jason-merlo/muse/README.md

# Muse
A Spark Core based music visualizer using the MSEGEQ7 spectrum analyzer IC

Bill of materials for v1.2 located at: https://goo.gl/ZPPZxI

A full writeup for this project will hopefully come sometime in the near future.
