jason-merlo/muse/Hardware V1.0/muse.pdf

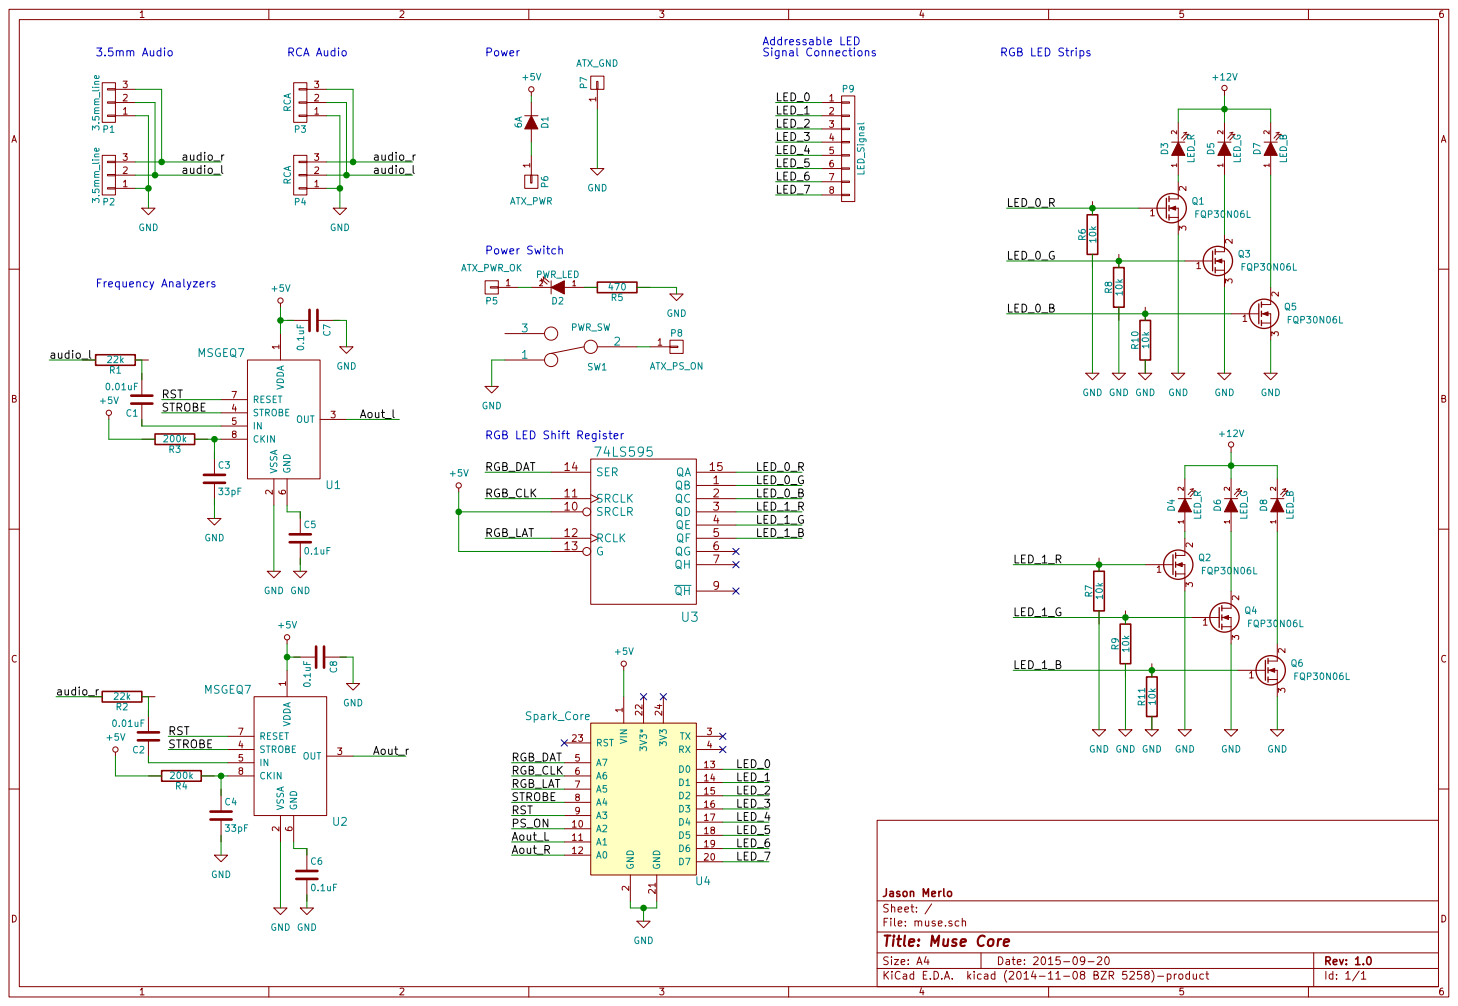
[picture p1: page 1]

2 TX 3 RX 4 A7 5 A6 6 A5 7 A4 8 A3 9 A2 10 D7 20 A1 11 GND 21 A0 12 3V3* 22 D0 13 RST 23 D1 14 3V3 24 D2 15 D3 16 D4 17 D5 18 D6 19 U4 Spark_Core VDDA

1 GND
File: muse.sch Sheet: / Jason Merlo VIN

Id: 1/1 Title: Muse Core
