jason-merlo/muse/Hardware V1.0/muse.kicad_pcb

## KiCad design Hardware V1.0/muse.kicad_pcb (2015-12-21, an earlier design)

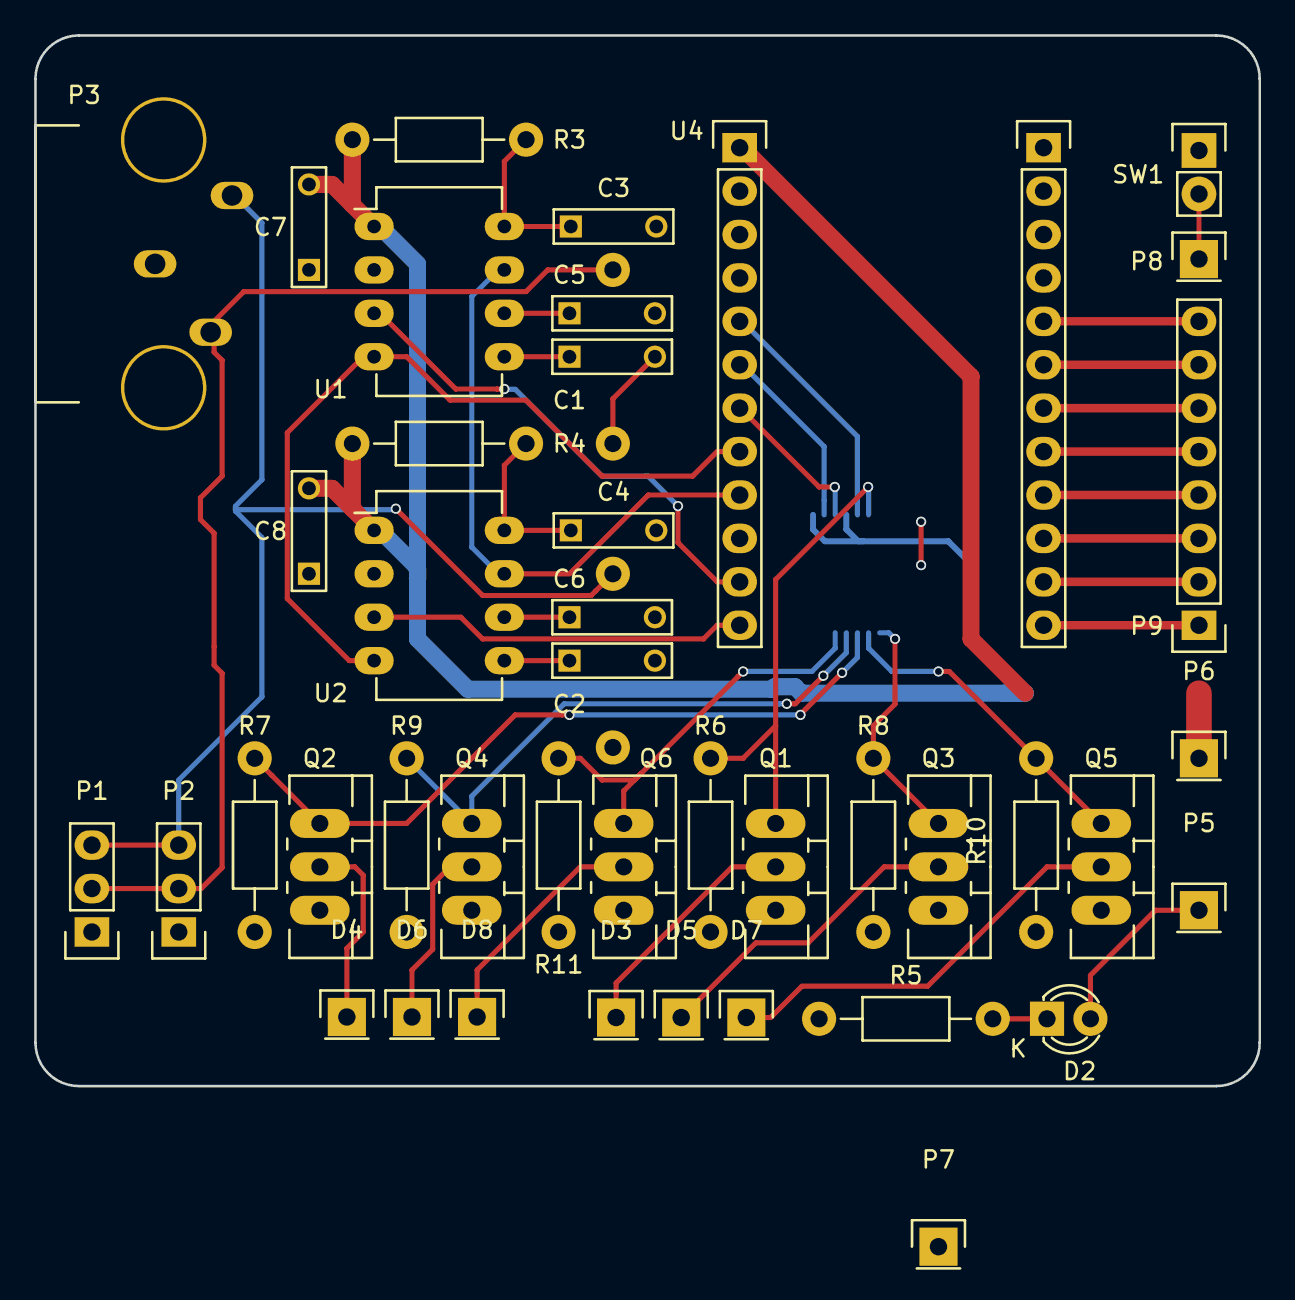
[picture p2: board Hardware V1.0/muse.kicad_pcb from above]

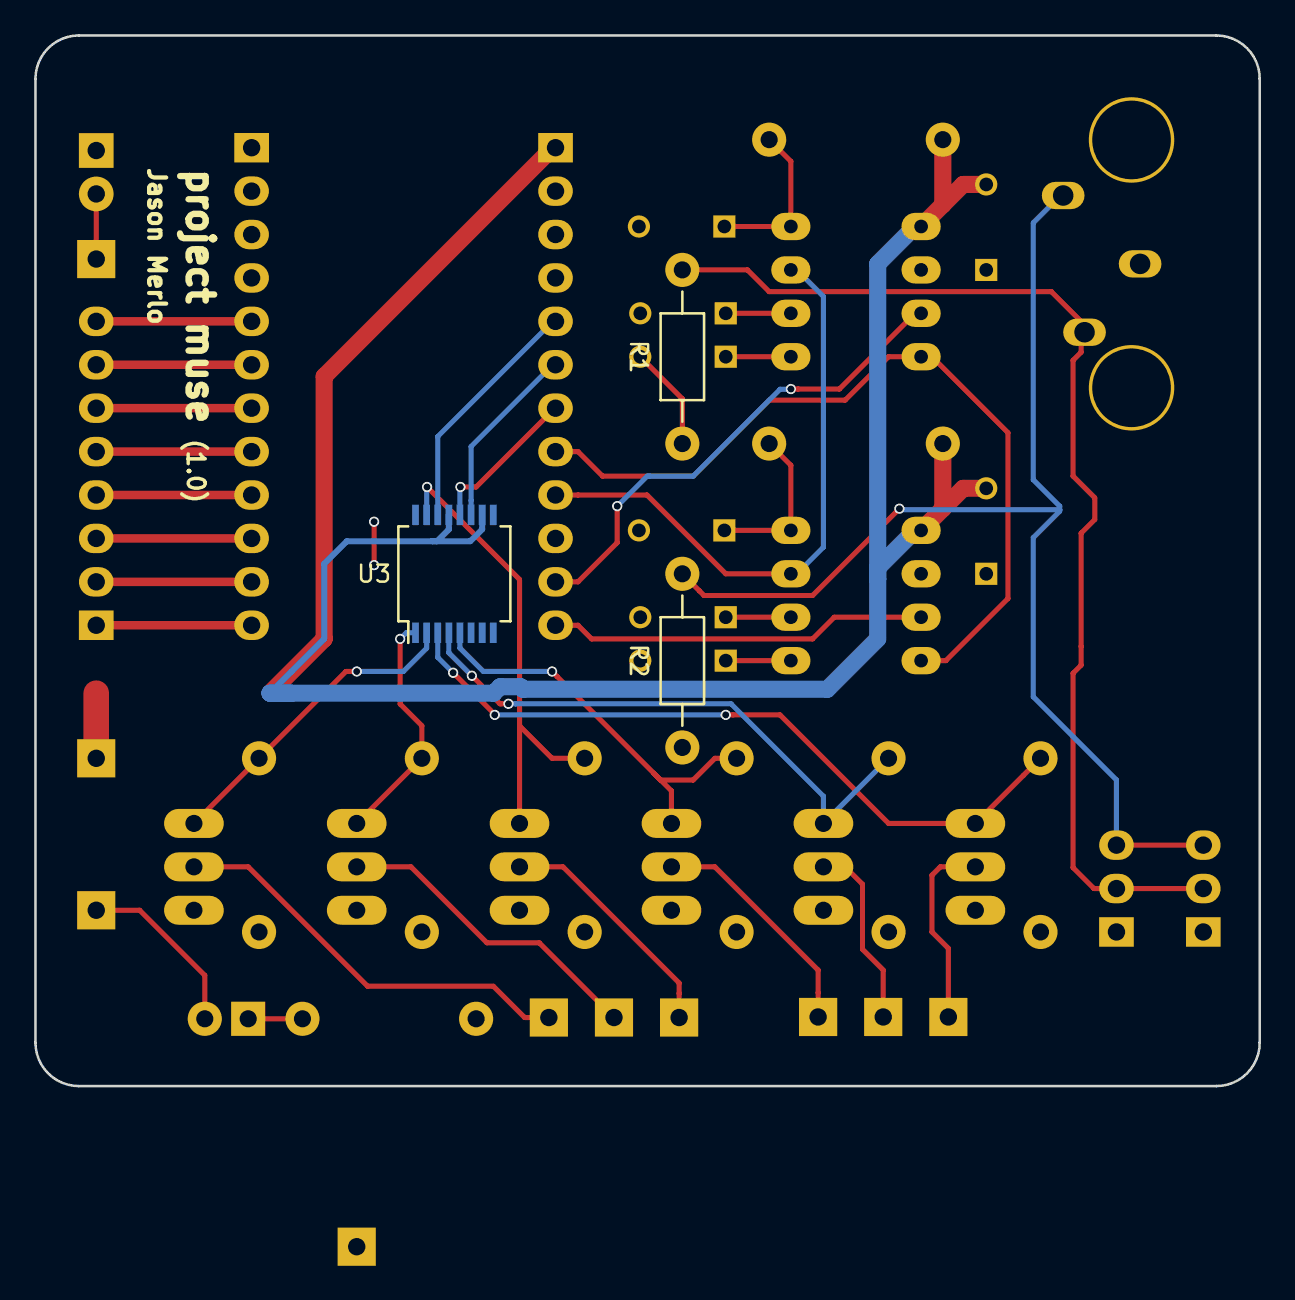
[picture p3: board Hardware V1.0/muse.kicad_pcb from below]

Board: 2 copper layers, 71.6 x 61.5 mm, 45 parts (3 on the bottom side), 42 nets.

Parts:
C1, C2: 0.01uF; C_Rect_L7_W2_P5
C3, C4: 33pF; C_Rect_L7_W2_P5
C5, C6, C7, C8: 0.1uF; C_Rect_L7_W2_P5
D2: PWR_LED; LED-3MM
D3, D4: LED_R; Pin_Header_Straight_1x01
D5, D6: LED_G; Pin_Header_Straight_1x01
D7, D8: LED_B; Pin_Header_Straight_1x01
P1, P2: 3.5mm_line; Pin_Header_Straight_1x03
P3: RCA; Audio_RCA_Vertical
P5: ATX_PWR_OK; Pin_Header_Straight_1x01
P6: ATX_PWR; Pin_Header_Straight_1x01
P7: ATX_GND; Pin_Header_Straight_1x01
P8: ATX_PS_ON; Pin_Header_Straight_1x01
P9: LED_Signal; Pin_Header_Straight_1x08
Q1, Q2, Q3, Q4, Q5, Q6: FQP30N06L; TO-220_Neutral123_Vertical_LargePads
R1, R2: 22k; Resistor_Horizontal_RM10mm
R3, R4: 200k; Resistor_Horizontal_RM10mm
R5: 470; Resistor_Horizontal_RM10mm
R6, R7, R8, R9, R10, R11: 10k; Resistor_Horizontal_RM10mm
SW1: PWR_SW; Pin_Header_Straight_1x02
U1, U2: MSGEQ7; DIP-8_W7.62mm_LongPads
U3: 74LS595; SSOP-16_5.3x6.2mm_Pitch0.65mm
U4: Spark_Core

Connections:
+5V: C7.2, C8.2, R3.2, R4.2, U1.1, U2.1, U3.10, U3.13, U4.1
/Aout_L: U1.3, U4.11
/Aout_R: U2.3, U4.12
/LED_0: P9.1, U4.13
/LED_0_B: Q5.1, R10.2, U3.2
/LED_0_G: Q3.1, R8.2, U3.1
/LED_0_R: Q1.1, R6.2, U3.15
/LED_1: P9.2, U4.14
/LED_1_B: Q6.1, R11.2, U3.5
/LED_1_G: Q4.1, R9.2, U3.4
/LED_1_R: Q2.1, R7.2, U3.3
/LED_2: P9.3, U4.15
/LED_3: P9.4, U4.16
/LED_4: P9.5, U4.17
/LED_5: P9.6, U4.18
/LED_6: P9.7, U4.19
/LED_7: P9.8, U4.20
/RGB_CLK: U3.11, U4.6
/RGB_DAT: U3.14, U4.5
/RGB_LAT: U3.12, U4.7
/RST: U1.7, U2.7, U4.9
/STROBE: U1.4, U2.4, U4.8
/audio_l: P1.2, P2.2, R1.2
/audio_r: P1.3, P2.3, R2.2
GND: C3.2, C4.2, C5.2, C6.2, C7.1, C8.1, P1.1, P2.1, P7.1, Q1.3, Q2.3, Q3.3, Q4.3, Q5.3, Q6.3, R5.1, R6.1, R7.1, R8.1, R9.1, R10.1, R11.1, SW1.1, U1.2, U2.2, U3.8, U4.2, U4.21
unnamed: C1.1, U1.5
unnamed: C1.2, R1.1
unnamed: C2.1, U2.5
unnamed: C2.2, R2.1
unnamed: C3.1, R3.1, U1.8
unnamed: C4.1, R4.1, U2.8
unnamed: C5.1, U1.6
unnamed: C6.1, U2.6
unnamed: D2.1, R5.2
unnamed: D2.2, P5.1
unnamed: D3.1, Q1.2
unnamed: D4.1, Q2.2
unnamed: D5.1, Q3.2
unnamed: D6.1, Q4.2
unnamed: D7.1, Q5.2
unnamed: D8.1, Q6.2
unnamed: P8.1, SW1.2
