jason-merlo/muse/Hardware V1.3/muse.kicad_pcb

## KiCad design Hardware V1.3/muse.kicad_pcb (2021-03-27, an earlier design)

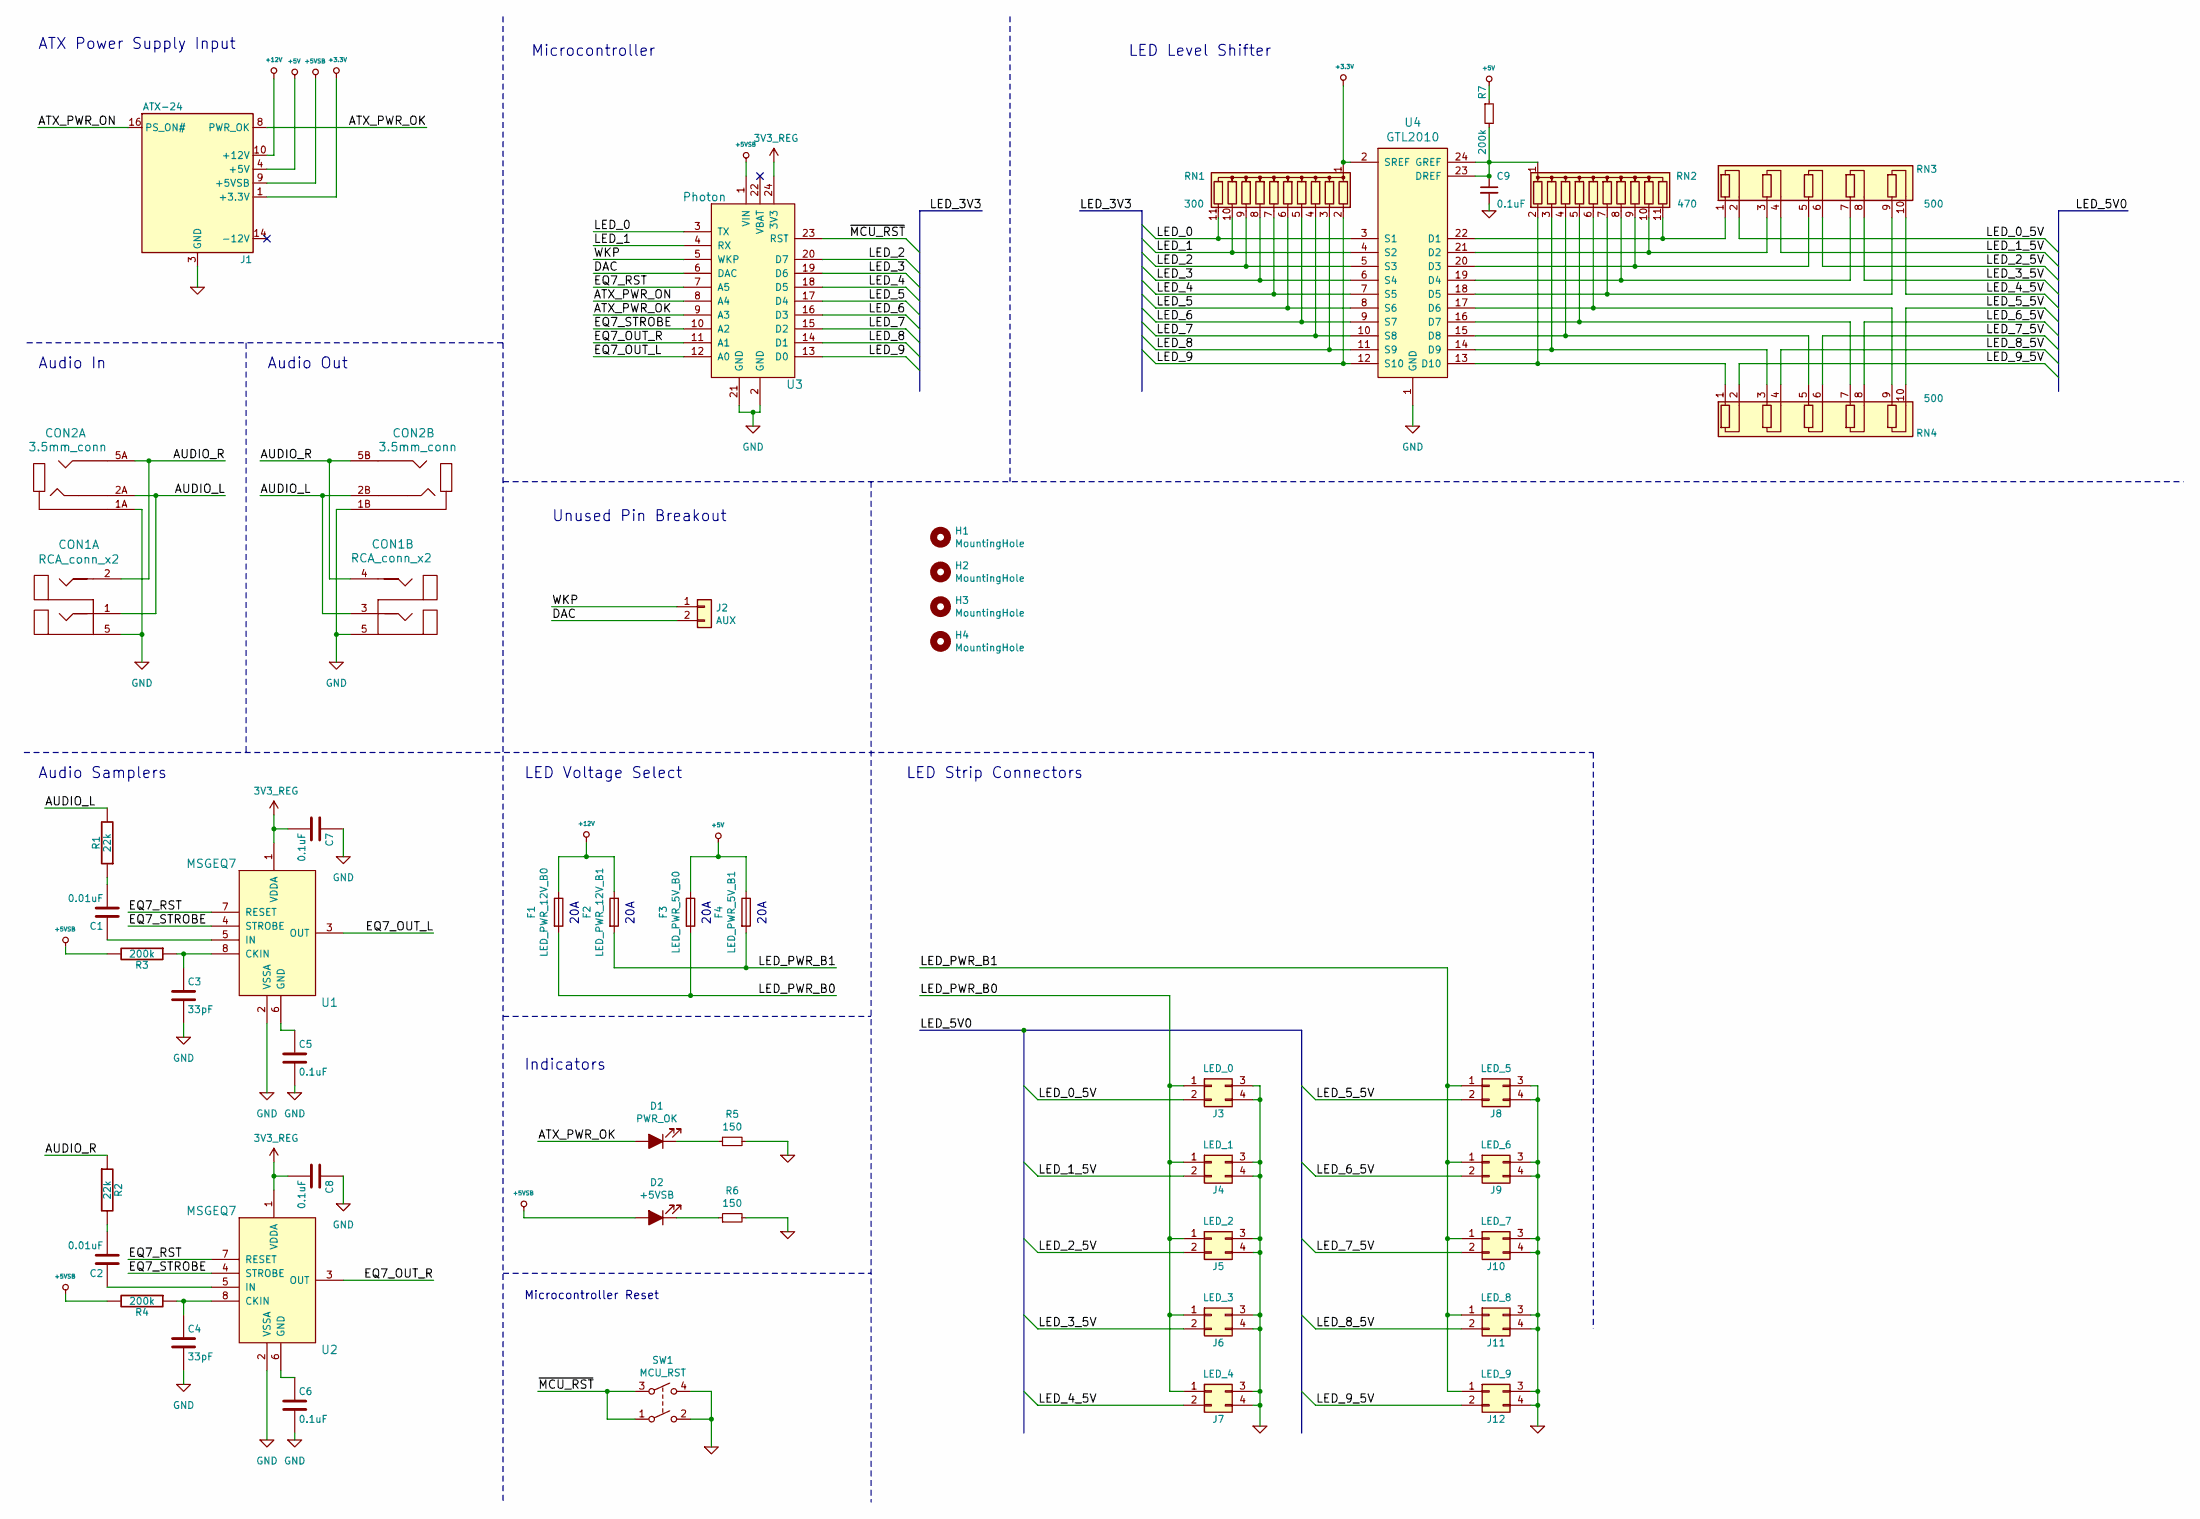
[picture p4: schematic muse.sch]

Parts:
C1, C2: 0.01uF; C_Rect_L4.6mm_W3.0mm_P2.50mm_MKS02_FKP02
C3, C4: 33pF; C_Rect_L4.6mm_W3.0mm_P2.50mm_MKS02_FKP02
C5, C6, C7, C8, C9: 0.1uF; C_Rect_L4.6mm_W3.0mm_P2.50mm_MKS02_FKP02
CON1: RCA_conn_x2; PJRAS2X2S01X
CON2: 3.5mm_conn; STX423535N
D1: PWR_OK; LED_D3.0mm
D2: +5VSB; LED_D3.0mm
F1: LED_PWR_12V_B0; Fuseholder_Blade_Mini_Keystone_3568
F2: LED_PWR_12V_B1; Fuseholder_Blade_Mini_Keystone_3568
F3: LED_PWR_5V_B0; Fuseholder_Blade_Mini_Keystone_3568
F4: LED_PWR_5V_B1; Fuseholder_Blade_Mini_Keystone_3568
H1, H2, H3, H4: MountingHole; MountingHole_3.2mm_M3
J1: ATX-24; Molex_Mini-Fit_Jr_5569-24A1_2x12_P4.20mm_Horizontal
J2: AUX; PinHeader_1x02_P2.54mm_Vertical
J3: LED_0; Molex_Mini-Fit_Jr_5569-04A1_2x02_P4.20mm_Horizontal
J4: LED_1; Molex_Mini-Fit_Jr_5569-04A1_2x02_P4.20mm_Horizontal
J5: LED_2; Molex_Mini-Fit_Jr_5569-04A1_2x02_P4.20mm_Horizontal
J6: LED_3; Molex_Mini-Fit_Jr_5569-04A1_2x02_P4.20mm_Horizontal
J7: LED_4; Molex_Mini-Fit_Jr_5569-04A1_2x02_P4.20mm_Horizontal
J8: LED_5; Molex_Mini-Fit_Jr_5569-04A1_2x02_P4.20mm_Horizontal
J9: LED_6; Molex_Mini-Fit_Jr_5569-04A1_2x02_P4.20mm_Horizontal
J10: LED_7; Molex_Mini-Fit_Jr_5569-04A1_2x02_P4.20mm_Horizontal
J11: LED_8; Molex_Mini-Fit_Jr_5569-04A1_2x02_P4.20mm_Horizontal
J12: LED_9; Molex_Mini-Fit_Jr_5569-04A1_2x02_P4.20mm_Horizontal
R1, R2: 22k; R_Axial_DIN0207_L6.3mm_D2.5mm_P10.16mm_Horizontal
R3, R4, R7: 200k; R_Axial_DIN0207_L6.3mm_D2.5mm_P10.16mm_Horizontal
R5, R6: 150; R_Axial_DIN0207_L6.3mm_D2.5mm_P10.16mm_Horizontal
RN1: 300; R_Array_SIP11
RN2: 470; R_Array_SIP11
RN3, RN4: 500; R_Array_SIP10
SW1: MCU_RST; SW_TH_Tactile_Omron_B3F-10xx
U1, U2: MSGEQ7; DIP-8_W7.62mm_LongPads
U3: Photon; photon_tht
U4: GTL2010; TSSOP-24_4.4x7.8mm_P0.65mm

Connections:
+3.3V: J1.1 (+3.3V), J1.2 (+3.3V), J1.12 (+3.3V), J1.13 (+3.3V), RN1.1 (common), U4.2 (SREF)
+3.3V_REG: C7.2, C8.2, U1.1 (VDDA), U2.1 (VDDA), U3.24 (3V3)
+5V: F3.1, F4.1, J1.4 (+5V), J1.6 (+5V), J1.21 (+5V), J1.22 (+5V), J1.23 (+5V), R7.1
+5VSB: D2.2 (A), J1.9 (+5VSB), R3.2, R4.2, U3.1 (VIN)
+12V: F1.1, F2.1, J1.10 (+12V), J1.11 (+12V)
/ATX_PWR_OK: D1.2 (A), J1.8 (PWR_OK), U3.9 (A3)
/ATX_PWR_ON: J1.16 (PS_ON#), U3.8 (A4)
/AUDIO_L: CON1.1, CON1.3, CON2.2A, CON2.2B, R1.2
/AUDIO_R: CON1.2, CON1.4, CON2.5A, CON2.5B, R2.1
/DAC: J2.2, U3.6 (DAC)
/EQ7_OUT_L: U1.3 (OUT), U3.12 (A0)
/EQ7_OUT_R: U2.3 (OUT), U3.11 (A1)
/EQ7_RST: U1.7 (RESET), U2.7 (RESET), U3.7 (A5)
/EQ7_STROBE: U1.4 (STROBE), U2.4 (STROBE), U3.10 (A2)
/LED_0: RN1.11 (R10), U3.3 (TX), U4.3 (S1)
/LED_0_5V: J3.2, RN3.2 (R1.2)
/LED_1: RN1.10 (R9), U3.4 (RX), U4.4 (S2)
/LED_1_5V: J4.2, RN3.4 (R2.2)
/LED_2: RN1.9 (R8), U3.20 (D7), U4.5 (S3)
/LED_2_5V: J5.2, RN3.6 (R3.2)
/LED_3: RN1.8 (R7), U3.19 (D6), U4.6 (S4)
/LED_3_5V: J6.2, RN3.8 (R4.2)
/LED_4: RN1.7 (R6), U3.18 (D5), U4.7 (S5)
/LED_4_5V: J7.2, RN3.10 (R5.2)
/LED_5: RN1.6 (R5), U3.17 (D4), U4.8 (S6)
/LED_5_5V: J8.2, RN4.10 (R5.2)
/LED_6: RN1.5 (R4), U3.16 (D3), U4.9 (S7)
/LED_6_5V: J9.2, RN4.8 (R4.2)
/LED_7: RN1.4 (R3), U3.15 (D2), U4.10 (S8)
/LED_7_5V: J10.2, RN4.6 (R3.2)
/LED_8: RN1.3 (R2), U3.14 (D1), U4.11 (S9)
/LED_8_5V: J11.2, RN4.4 (R2.2)
/LED_9: RN1.2 (R1), U3.13 (D0), U4.12 (S10)
/LED_9_5V: J12.2, RN4.2 (R1.2)
/LED_PWR_B0: F1.2, F3.2, J3.1, J4.1, J5.1, J6.1, J7.1
/LED_PWR_B1: F2.2, F4.2, J8.1, J9.1, J10.1, J11.1, J12.1
/WKP: J2.1, U3.5 (WKP)
/~MCU_RST: SW1.1, SW1.3, U3.23 (RST)
unnamed: C1.1, U1.5 (IN)
unnamed: C1.2, R1.1
unnamed: C2.1, U2.5 (IN)
unnamed: C2.2, R2.2
unnamed: C3.1, R3.1, U1.8 (CKIN)
unnamed: C4.1, R4.1, U2.8 (CKIN)
unnamed: C5.1, U1.6 (GND)
unnamed: C6.1, U2.6 (GND)
unnamed: C9.1, R7.2, RN2.1 (common), U4.23 (DREF), U4.24 (GREF)
unnamed: D1.1 (K), R5.1
unnamed: D2.1 (K), R6.1
unnamed: RN2.2 (R1), RN4.1 (R1.1), U4.13 (D10)
unnamed: RN2.3 (R2), RN4.3 (R2.1), U4.14 (D9)
unnamed: RN2.4 (R3), RN4.5 (R3.1), U4.15 (D8)
unnamed: RN2.5 (R4), RN4.7 (R4.1), U4.16 (D7)
unnamed: RN2.6 (R5), RN4.9 (R5.1), U4.17 (D6)
unnamed: RN2.7 (R6), RN3.9 (R5.1), U4.18 (D5)
unnamed: RN2.8 (R7), RN3.7 (R4.1), U4.19 (D4)
unnamed: RN2.9 (R8), RN3.5 (R3.1), U4.20 (D3)
unnamed: RN2.10 (R9), RN3.3 (R2.1), U4.21 (D2)
unnamed: RN2.11 (R10), RN3.1 (R1.1), U4.22 (D1)

Notes on the sheet:
Audio Samplers
LED Level Shifter
ATX Power Supply Input
Audio Out
Audio In
Microcontroller
LED Strip Connectors
Unused Pin Breakout
20A
LED Voltage Select
Indicators
Microcontroller Reset

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
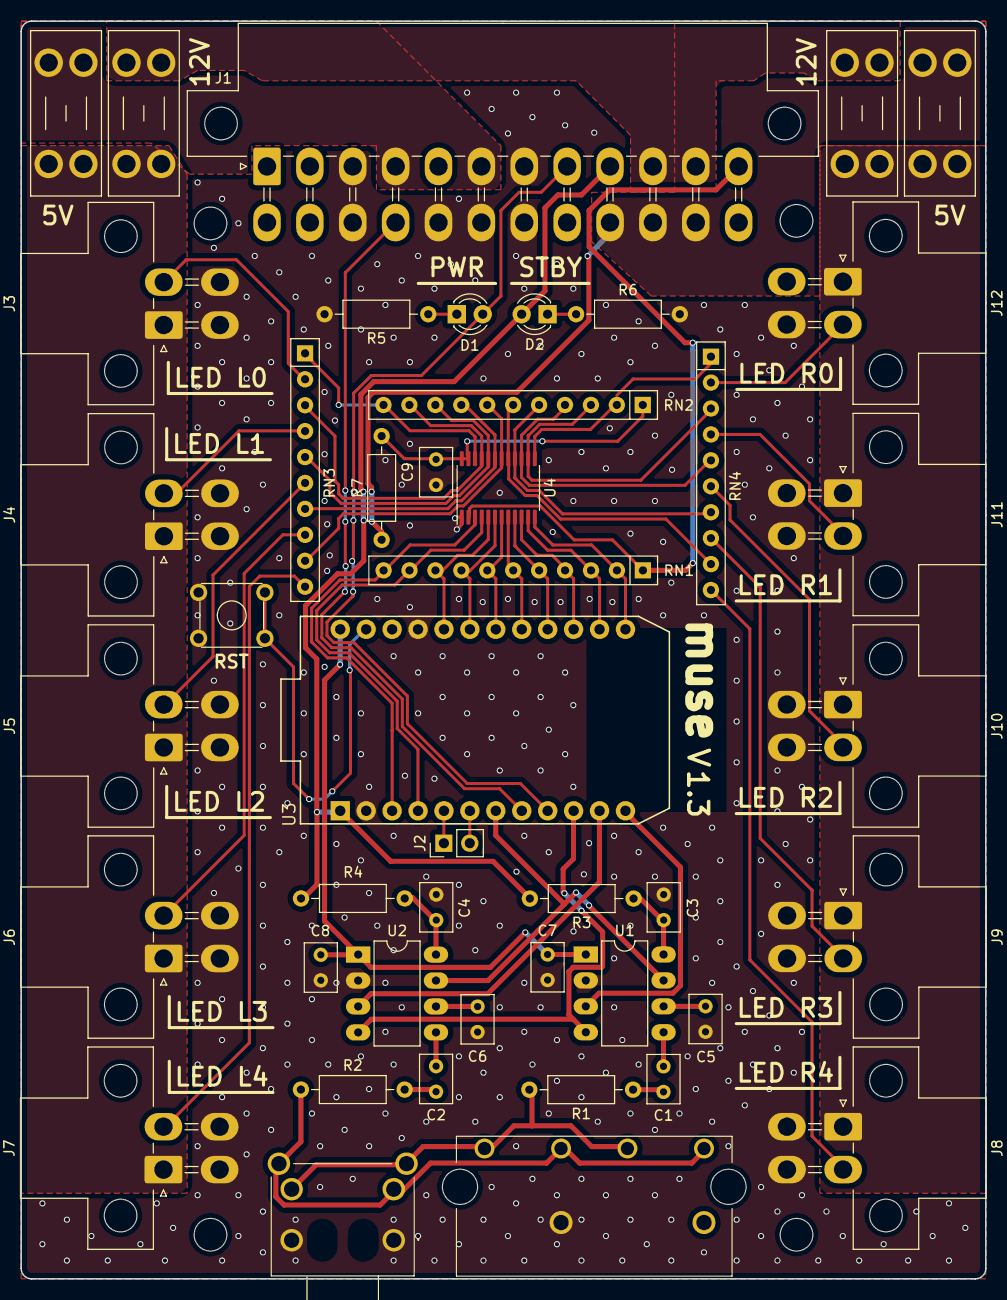
[picture p5: board Hardware V1.3/muse.kicad_pcb from above]

Board: 2 copper layers, 94.5 x 123.2 mm, 49 parts (0 on the bottom side), 60 nets.
