jason-merlo/muse/muse/bar_matrix.cpp

/* ================================================================== *
 *  Written by Jason Merlo
 *
 *  updates:
 *  11/17/2015
 *
 *  File: bar_matrix.cpp
 *
 *  Description: Class to control LED bar matrix and run visualizers
 * ================================================================== */

#include "bar_matrix.h"
#include "math.h"

// Display variables
short disp_width;
short disp_height;
unsigned long** display;
Adafruit_NeoPixel** bars;

Beat_Detection * bd;

int color_table_idx = 0;

/* ================================================================== *
 * Bar_matrix
 *
 * num_bars - number of LED bars
 * bar_len - number of leds in each bar (strip length)
 * orientation - horizontal or vertical bars (horizontal/ladder = 0; vertical/fence = 1)
 * ================================================================== */
Bar_Matrix::Bar_Matrix(short num_bars, short bar_len, const char led_type, const char* pins, Beat_Detection* beat_detection) {
    disp_width = num_bars; //(orientation) ? num_bars : bar_len;
    disp_height = bar_len; //(orientation) ? bar_len : num_bars;

    display = new unsigned long*[disp_width];
    for (int i = 0; i < disp_width; i++)
    display[i] = new unsigned long[disp_height];

    bars = new Adafruit_NeoPixel*[num_bars];
    for(short i = 0; i < num_bars; i++) {
        bars[i] = new Adafruit_NeoPixel(bar_len, pins[i], led_type);

        // Set up variables to track bouncing lines
        bouncing_line_lengths[i] = random(10, STRIP_LENGTH / 2);
        bouncing_line_positions[i] = random(0, STRIP_LENGTH);
        //bouncing_line_positions[i] = (i%2 == 0) ? 0 : STRIP_LENGTH;
        if (random(0, 10) > 5) bouncing_line_directions[i] = 1;
        else                bouncing_line_directions[i] = -1;

        bouncing_line_speeds[i] = (float)random(5, 10) / 15.0;

        bouncing_line_colors[i][0] = bd->r();
        bouncing_line_colors[i][1] = bd->g();
        bouncing_line_colors[i][2] = bd->b();
    }

    color_table_idx = 0;
    snakes[0] = Snake(1, 30, -30, COLOR_TABLE[color_table_idx][0], COLOR_TABLE[color_table_idx][1], COLOR_TABLE[color_table_idx][2]);
    color_table_idx++;
    snakes[1] = Snake(-1, 25, NUM_BARS/2*STRIP_LENGTH, COLOR_TABLE[color_table_idx][0], COLOR_TABLE[color_table_idx][1], COLOR_TABLE[color_table_idx][2]);
    color_table_idx++;
    snakes[2] = Snake(1, 20, 185, COLOR_TABLE[color_table_idx][0], COLOR_TABLE[color_table_idx][1], COLOR_TABLE[color_table_idx][2]);
    color_table_idx++;
    snakes[3] = Snake(-1, 15, NUM_BARS*STRIP_LENGTH, COLOR_TABLE[color_table_idx][0], COLOR_TABLE[color_table_idx][1], COLOR_TABLE[color_table_idx][2]);
    color_table_idx++;

    snakes[0].posTicks = 0;
    snakes[0].ticksNeeded = 1;
    snakes[1].posTicks = 0;
    snakes[1].ticksNeeded = 1;
    snakes[2].posTicks = 0;
    snakes[2].ticksNeeded = 1;
    snakes[3].posTicks = 0;
    snakes[3].ticksNeeded = 1;

    pongPaddles[0] = PongPaddle(15, 0, STRIP_LENGTH/2, 0, 0.9, 15, 100, 100, 100);
    pongPaddles[1] = PongPaddle(15, NUM_BARS-1, STRIP_LENGTH/2, 0, 0.9, 15, 100, 100, 100);
    pongBall = PongBall(3, 0.0625, 0.80, 15, 100, 100, 100);
    last_beat_count = 0;

    bass_slide_millis = millis();
    bass_slide_ema = 0.0;

    init_matrix();
    clear_matrix();

    bd = beat_detection;
}

/* ======================== PRIVATE FUNCTIONS ======================= */

/* ================================================================== *
 * Function: decay
 * Description: slowly fades out matrix values
 * Parameters: [float] factor - decay factor to be multiplied by
 * ================================================================== */
void Bar_Matrix::decay(double factor) {
    for (char i = 0; i < disp_width; i++) {
        for (char j = 0; j < disp_height; j++) {
            unsigned int color = bars[i]->getPixelColor(j);
            bars[i]->setPixelColor(j, (char)(color >> 16) * factor,
            (char)(color >> 8) * factor,
            (char)(color) * factor);
        }
    }
}

/* ================================================================== *
 * Function: decay_to_rgb
 * Description: slowly fades out matrix values to the specified rgb value
 * Parameters: [float] factor - decay factor to be multiplied by
 *             [int] r - the red value to fade to
 *             [int] g - the green value to fade to
 *             [int] b - the blue value to fade to
 * ================================================================== */
void Bar_Matrix::decay_to_rgb(double factor, int r, int g, int b) {
    for (char i = 0; i < disp_width; i++) {
        for (char j = 0; j < disp_height; j++) {
            unsigned int color = bars[i]->getPixelColor(j);

            // Decay and do bounds checking on rgb values
            int rx = (int) ((char)(color >> 16) * factor);
            int gx = (int) ((char)(color >>  8) * factor);
            int bx = (int) ((char)(color      ) * factor);
            if (rx < r) { rx = r; }
            if (gx < g) { gx = g; }
            if (bx < b) { bx = b; }

            bars[i]->setPixelColor(j, rx, gx, bx);
        }
    }
}

void Bar_Matrix::fill_bar(int bar, int r, int g, int b) {
    for (int j =0; j < disp_height; j++) {
        bars[bar]->setPixelColor(j, (uint8_t)r, (uint8_t)g, (uint8_t)b);
    }
}

/* ================================================================== *
 * Function: fill_matrix
 * Description: Sets all pixel values in matrix to given color value
 * Parameters: [Color]* color - color to set matrix to
 * ================================================================== */
void Bar_Matrix::fill_matrix(Color_Value c) {
    for (int i = 0; i < disp_width; i++) {
        for (int j =0; j< disp_height; j++) {
            bars[i]->setPixelColor(j, c.c);
        }
    }
}

/* ================================================================== *
 * Function: ambient_lighting
 * Description: Sets all pixel values in matrix to given color value
 * Parameters: [Color]* color - color to set matrix to
 * ================================================================== */
void Bar_Matrix::ambient_lighting(Color_Value c) {
    fill_matrix(c);
}


/* ================================================================== *
 * Function: init_matrix
 * Description: Initializes the matrix to off
 * ================================================================== */
void Bar_Matrix::init_matrix() {
    for (int i = 0; i < disp_width; i++) {
        // switch height and width based on orientation
        bars[i]->begin();
        bars[i]->show();
    }
}

void Bar_Matrix::mix_pixel(unsigned char bar, unsigned short pixel, float factor, unsigned char r, unsigned char g, unsigned char b) {
    unsigned int color = bars[bar]->getPixelColor(pixel);
    bars[bar]->setPixelColor(pixel, (char)(color >> 16) * (1-factor) + r * factor,
    (char)(color >> 8) * (1-factor) + g * factor,
    (char)(color) * (1-factor) + b * factor);
}

/* =================== PUBLIC MANAGEMENT FUNCTIONS ================== */

/* ================================================================== *
 * Function: clear_matrix
 * Description: Sets all pixel values to (0, 0, 0)
 * ================================================================== */
void Bar_Matrix::clear_matrix() {
    for (int i = 0; i < disp_width; i++) {
        for (int j =0; j< disp_height; j++) {
            bars[i]->setPixelColor(j, 0);
        }
    }
}

/* ================================================================== *
 * Function: show_all
 * Description: drives pixels in physical matrix to current values
 * ================================================================== */
void Bar_Matrix::show_all() {
    for (char i = 0; i < disp_width; i++) {
        bars[i]->show();
    }
}

/* ================================================================== *
 * Function: tick
 * Description: Draws the given visualizer to the bars
 * Parameters: [audio_bins *] bins - The audio sample bins
 *             [int] visualizer_type - The visualizer type to drive
 * ================================================================== */
void Bar_Matrix::tick(audio_bins * bins, int visualizer_type) {
    switch (visualizer_type) {
        // Visualizers
        case VISUALIZER_BARS:
          visualizer_bars(bins, 0.15, 0.85, false);
          break;
        case VISUALIZER_BARS_MIDDLE:
          visualizer_bars_middle(bins, 0.15, 0.85);
          break;
        case VISUALIZER_BASS_MIDDLE:
          visualizer_bass_middle(bins, 0.15, 0.80);
          break;
        case VISUALIZER_BASS_SLIDE:
          visualizer_bass_slide(bins, 0.15, 0.75);
          break;
        case VISUALIZER_CLASSIC:
            visualizer_classic(bins, 0.15, 0.9);
            break;
        case VISUALIZER_PLASMA:
          visualizer_plasma(bins, 0.5, 0.965);
          break;
        case VISUALIZER_PONG:
          visualizer_pong(0.965);
          break;
        case VISUALIZER_PULSE:
          visualizer_pulse(bins, 0.15, 0.8, 1.0f, 20.0f);
          break;
        case VISUALIZER_RAINBOW:
          visualizer_rainbow(bins, 0.15, 0.8);
          break;
        case VISUALIZER_WHEEL:
          visualizer_wheel(0.25, 10);
          break;

        // Tests and misc
        case BOUNCING_LINES:
            bouncing_lines();
            break;
        case SNAKE_LINES:
            snake_lines(0.75);
            break;
        case BAR_TEST:
            bar_test();
            break;
        case PIXEL_TEST:
            pixel_test();
            break;
        case AMBIENT_LIGHTING:
            ambient_lighting(Color_Value(200, 150, 100));
            break;
    }

    bd->frame_ticked();
    show_all();
}

/* ===================== MISC DRAWING FUNCTIONS ===================== */

/* ================================================================== *
 * Function: bar_test
 * Description: Turns on bars in order to test wiring
 * Parameters: None
 * ================================================================== */
void Bar_Matrix::bar_test() {
    for (int i = 0; i < STRIP_LENGTH; i++)
    bars[int(millis()/1000) % NUM_BARS]->setPixelColor(i, 64, 64, 64);
}

/* ================================================================== *
 * Function: bouncing_lines
 * Description: Bounces a solid line of LEDs up and down in each matrix bar
 * Parameters: none
 * ================================================================== */
void Bar_Matrix::bouncing_lines() {
    for (int i = 0; i < disp_width; i++) {
        int bottom = bouncing_line_positions[i];

        // Clear the pixel the line just left, light the one it entered
        if (bouncing_line_directions[i] == 1) {
            if (bottom > 0) mix_pixel(i, bottom-1, 1, 0, 0, 0);
            mix_pixel(i, 1+bottom+bouncing_line_lengths[i], 1, bouncing_line_colors[i][0], bouncing_line_colors[i][1], bouncing_line_colors[i][2]);//bd->r(), bd->g(), bd->b());
        } else {
            if (bottom > 0) mix_pixel(i, bottom-1, 1, bouncing_line_colors[i][0], bouncing_line_colors[i][1], bouncing_line_colors[i][2]);//bd->r(), bd->g(), bd->b());
            mix_pixel(i, 1+bottom+bouncing_line_lengths[i], 1, 0, 0, 0);
        }

        // Move the line
        bouncing_line_positions[i] += bouncing_line_directions[i] * bouncing_line_speeds[i];

        // Ensure we are moving in the proper direction
        if (bouncing_line_positions[i] < -.5*bouncing_line_lengths[i] && bouncing_line_directions[i] < 0) {
            bouncing_line_directions[i] = 1;
            if (random(0, 10) > 5) {
                int newlength = random(10, STRIP_LENGTH / 2);
                if (newlength > bouncing_line_lengths[i]) {
                    bouncing_line_positions[i] = (-1*newlength/2) - (newlength/2 - bouncing_line_lengths[i]/2);
                } else {
                    bouncing_line_positions[i] = -1 * newlength / 2;
                }

                bouncing_line_lengths[i] = newlength;
            }

            if (random(0, 10) > 7) {
                bouncing_line_speeds[i] = (float)random(5, 10) / 15.0;
            }

            bouncing_line_colors[i][0] = bd->r();
            bouncing_line_colors[i][1] = bd->g();
            bouncing_line_colors[i][2] = bd->b();
        } else if (bouncing_line_positions[i] > STRIP_LENGTH-.5*bouncing_line_lengths[i] && bouncing_line_directions[i] > 0) {
            bouncing_line_directions[i] = -1;

            bouncing_line_colors[i][0] = bd->r();
            bouncing_line_colors[i][1] = bd->g();
            bouncing_line_colors[i][2] = bd->b();
        }
    }
}

/* ================================================================== *
 * Function: bar_test
 * Description: Turns on lights from top to check length of srip
 * Parameters: None
 * ================================================================== */
void Bar_Matrix::pixel_test() {
    clear_matrix();
    for (int i = 0; i < NUM_BARS; i++)
    bars[i]->setPixelColor(STRIP_LENGTH-int(millis()/1000)%10, 64, 64, 64);
}

/* ================== VISUALIZER DRAWING FUNCTIONS ================== */

/* ================================================================== *
 * Function: visualizer_bars
 * Description: Sets all pixel values to given color value
 * Parameters: [audio_bins]* bins - frequency bins read from chip
 * ================================================================== */
 void Bar_Matrix::visualizer_bars(audio_bins* bins, float in_factor, float out_factor, bool strobe) {
   decay(out_factor);
   float bass_level = 0;
   int red, green, blue;

   if (strobe)
     bass_level = (log(((bins->left[LEFT_63]+bins->right[LEFT_63])/2.0f)/BINS_MAX)+0.7f) * 5 * 255.0f;

   for (char i = 0; i < disp_width; i++) {
     for (char j = 0; j < disp_height; j++) {
       // get bin
       //int level = (i < disp_width/2) ? bar_levels[i] : bar_levels[7-i];

       if (strobe)
         mix_pixel(i, j, 0.5f, bass_level, bass_level, bass_level);

       // Set bar levels
       int level = 0;
       if (disp_width == 8) {
        switch(i) {
            case 0:
            level = bins->left[LEFT_160];
            break;
            case 1:
            level = bins->left[LEFT_1000];
            break;
            case 2:
            level = bins->left[LEFT_6250];
            break;
            case 3:
            level = bins->left[LEFT_16000];
            break;
            case 4:
            level = bins->right[RIGHT_16000];
            break;
            case 5:
            level = bins->right[RIGHT_6250];
            break;
            case 6:
            level = bins->right[RIGHT_1000];
            break;
            case 7:
            level = bins->right[RIGHT_160];
            break;
        }
        } else if (disp_width == 10) {
            switch(i) {
            case 0:
            level = bins->left[LEFT_63];
            break;
            case 1:
            level = bins->left[LEFT_160];
            break;
            case 2:
            level = bins->left[LEFT_400];
            break;
            case 3:
            level = bins->left[LEFT_1000];
            break;
            case 4:
            level = bins->left[LEFT_6250];
            break;
            case 5:
            level = bins->right[RIGHT_6250];
            break;
            case 6:
            level = bins->right[RIGHT_1000];
            break;
            case 7:
            level = bins->right[RIGHT_400];
            break;
            case 8:
            level = bins->right[RIGHT_160];
            break;
            case 9:
            level = bins->right[RIGHT_63];
            break;
        }  
       }

       level *= FREQ_GAIN;
       // set bar
       if (j < (pow((float)(level)/(float)(BINS_MAX), 2)) * (STRIP_LENGTH)) {
       //if (j < (float)(level)/(float)(BINS_MAX) * (STRIP_LENGTH))

         float val = level*2*PI/BINS_MAX;

         // Select colors
         switch(bd->num_beats() % 3) {
           case 0:
             red = cos(val)*255;
             green = cos(val - 2*PI/3)*255;
             blue = cos(val - 4*PI/3)*255;
             break;
           case 1:
             red = cos(val - 4*PI/3)*255;
             green = cos(val)*255;
             blue = cos(val - 2*PI/3)*255;
             break;
           case 2:
             red = cos(val - 2*PI/3)*255;
             green = cos(val - 4*PI/3)*255;
             blue = cos(val)*255;
             break;
         }

         mix_pixel(i, j, in_factor, red, green, blue);
         /*mix_pixel(i, j, in_factor, cos(val)*255, cos(val - 2*pi/3)*255, cos(val - 4*pi/3)*255);*/

         /*mix_pixel(i, j, in_factor, bins->left[0]/16,
                                    bins->left[1]/16,
                                    bins->left[2]/16);*/

         /*mix_pixel(i, j, in_factor, bins->left[0]/(64-(bins->left[1]/128)),
                                    bins->left[1]/(64-(bins->left[2]/128)),
                                    bins->left[2]/(64-(bins->left[0]/128)));*/
       }
     }
   }
 }

/* ================================================================== *
 * Function: visualizer_bars_middle
 * Description: Bars start at the middle and go to the edges.
 *              One channel fills up, the other fills down.
 * Parameters: none.
 * ================================================================== */
void Bar_Matrix::visualizer_bars_middle(audio_bins* bins, float in_factor, float out_factor) {
    decay(out_factor);

    if (bd->beat_on_bin(0) || bd->beat_on_bin(1)) {
        //fill_bar(i, COLOR_TABLE[color_table_idx][0], COLOR_TABLE[color_table_idx][1], COLOR_TABLE[color_table_idx][2]);
        color_table_idx = (color_table_idx+1) % 51;
    }

    // Right bins, grows downwards
    for (char i = 0; i < disp_width; i++) {
        for (char j = 0; j < STRIP_LENGTH/2; j++) {
            // get bin
            // Set bar levels
            int level = 0;
            if (disp_width == 8) {
                switch(i) {
                    case 0:
                    level = bins->left[LEFT_160];
                    break;
                    case 1:
                    level = bins->left[LEFT_1000];
                    break;
                    case 2:
                    level = bins->left[LEFT_6250];
                    break;
                    case 3:
                    level = bins->left[LEFT_16000];
                    break;
                    case 4:
                    level = bins->right[RIGHT_16000];
                    break;
                    case 5:
                    level = bins->right[RIGHT_6250];
                    break;
                    case 6:
                    level = bins->right[RIGHT_1000];
                    break;
                    case 7:
                    level = bins->right[RIGHT_160];
                    break;
                }
            } else if (disp_width == 10) {
                switch(i) {
                    case 0:
                    level = bins->left[LEFT_63];
                    break;
                    case 1:
                    level = bins->left[LEFT_160];
                    break;
                    case 2:
                    level = bins->left[LEFT_400];
                    break;
                    case 3:
                    level = bins->left[LEFT_1000];
                    break;
                    case 4:
                    level = bins->left[LEFT_6250];
                    break;
                    case 5:
                    level = bins->right[RIGHT_6250];
                    break;
                    case 6:
                    level = bins->right[RIGHT_1000];
                    break;
                    case 7:
                    level = bins->right[RIGHT_400];
                    break;
                    case 8:
                    level = bins->right[RIGHT_160];
                    break;
                    case 9:
                    level = bins->right[RIGHT_63];
                    break;
                }  
            }
            level *= FREQ_GAIN;
            // set bar
            float p = (float)(level)/(float)(BINS_MAX);
            if (j < p*p * (STRIP_LENGTH/2)) {
                //j < (pow((float)(level)/(float)(BINS_MAX), 2)) * (STRIP_LENGTH/2)) {
                float val = level*2*PI/BINS_MAX;
                //mix_pixel(i, STRIP_LENGTH/2 - j, in_factor, cos(val)*255, cos(val - 2*PI/3)*255, cos(val - 4*PI/3)*255);
                //mix_pixel(i, STRIP_LENGTH/2 - j, in_factor, bd->r(), bd->g(), bd->b());
                mix_pixel(i, STRIP_LENGTH/2 - j, in_factor, COLOR_TABLE[color_table_idx][0], COLOR_TABLE[color_table_idx][1], COLOR_TABLE[color_table_idx][2]);
            }
        }

        // Left bins, grow upwards
        for (char j = STRIP_LENGTH/2; j < STRIP_LENGTH; j++) {
            // get bin
            int level = 0;
            if (disp_width == 8) {
                switch(i) {
                    case 0:
                    level = bins->left[LEFT_160];
                    break;
                    case 1:
                    level = bins->left[LEFT_1000];
                    break;
                    case 2:
                    level = bins->left[LEFT_6250];
                    break;
                    case 3:
                    level = bins->left[LEFT_16000];
                    break;
                    case 4:
                    level = bins->right[RIGHT_16000];
                    break;
                    case 5:
                    level = bins->right[RIGHT_6250];
                    break;
                    case 6:
                    level = bins->right[RIGHT_1000];
                    break;
                    case 7:
                    level = bins->right[RIGHT_160];
                    break;
                }
            } else if (disp_width == 10) {
                switch(i) {
                    case 0:
                    level = bins->left[LEFT_63];
                    break;
                    case 1:
                    level = bins->left[LEFT_160];
                    break;
                    case 2:
                    level = bins->left[LEFT_400];
                    break;
                    case 3:
                    level = bins->left[LEFT_1000];
                    break;
                    case 4:
                    level = bins->left[LEFT_6250];
                    break;
                    case 5:
                    level = bins->right[RIGHT_6250];
                    break;
                    case 6:
                    level = bins->right[RIGHT_1000];
                    break;
                    case 7:
                    level = bins->right[RIGHT_400];
                    break;
                    case 8:
                    level = bins->right[RIGHT_160];
                    break;
                    case 9:
                    level = bins->right[RIGHT_63];
                    break;
                }  
            }
            level *= FREQ_GAIN;
            // set bar
            float p = (float)(level)/(float)(BINS_MAX);
            if (j-STRIP_LENGTH/2 < p*p * (STRIP_LENGTH/2)) {
                //j-STRIP_LENGTH/2 < (pow((float)(level)/(float)(BINS_MAX), 2)) * (STRIP_LENGTH/2)) {
                float val = level*2*PI/BINS_MAX;
                //mix_pixel(i, j, in_factor, cos(val)*255, cos(val - 2*PI/3)*255, cos(val - 4*PI/3)*255);
                //mix_pixel(i, j, in_factor, bd->r(), bd->g(), bd->b());//reds[i], greens[i], blues[i]);
                mix_pixel(i, j, in_factor, COLOR_TABLE[color_table_idx][0], COLOR_TABLE[color_table_idx][1], COLOR_TABLE[color_table_idx][2]);
            }
        }
    }
}

/* ================================================================== *
 * Function: visualizer_bass_middle
 * Description: All bars react to bass beats. Bulge in middle of display
 * Parameters: none.
 * ================================================================== */
void Bar_Matrix::visualizer_bass_middle(audio_bins* bins, float in_factor, float out_factor) {
    decay(out_factor);

    if (bd->num_beats() != last_beat_count) {
        last_beat_count = bd->num_beats();
        color_table_idx++;
        color_table_idx %= 51;
    }

    // Average all 4 low frequency bins
    float energy = bins->right[RIGHT_63] + bins->left[LEFT_63] + bins->right[RIGHT_160] + bins->left[LEFT_160];
    energy /= 4.0;
    energy /= (float) BINS_MAX;
    energy *= energy;
    // Use the "energy" of the low frequency bins to determine number of LEDs to light
    // Add 0.5 forces round to nearest integer
    int max_lit = (energy * (float)STRIP_LENGTH) + 0.5;
    int middle_led = STRIP_LENGTH / 2;

    for (int x = 0; x < NUM_BARS / 2; x++) {
        int num_lit = max_lit / (NUM_BARS/2 - x);
        int y = (STRIP_LENGTH / 2) - (num_lit / 2);

        for (int i = 0; i < num_lit; i++) {
            mix_pixel(x, y+i, in_factor, COLOR_TABLE[color_table_idx][0], COLOR_TABLE[color_table_idx][1], COLOR_TABLE[color_table_idx][2]);
            mix_pixel(NUM_BARS-x-1, y+i, in_factor, COLOR_TABLE[color_table_idx][0], COLOR_TABLE[color_table_idx][1], COLOR_TABLE[color_table_idx][2]);
        }
    }
}

/* ================================================================== *
 * Function: visualizer_bass_slide
 * Description: All bars react to bass beats. Bulge in middle of display
 * Parameters: none.
 * ================================================================== */
void Bar_Matrix::visualizer_bass_slide(audio_bins* bins, float in_factor, float out_factor) {
    decay(out_factor);

    if (bd->num_beats() != last_beat_count) {
        last_beat_count = bd->num_beats();
        color_table_idx++;
        color_table_idx %= 51;
    }

    // Average all 4 low frequency bins
    float energy = (bins->right[RIGHT_63] + bins->left[LEFT_63]) + (bins->right[RIGHT_160] + bins->left[LEFT_160])+ (bins->right[RIGHT_400] + bins->left[LEFT_400])+ (bins->right[RIGHT_1000] + bins->left[LEFT_1000])+ (bins->right[RIGHT_2500] + bins->left[LEFT_2500])+ (bins->right[RIGHT_6250] + bins->left[LEFT_6250])+ (bins->right[RIGHT_16000] + bins->left[LEFT_16000]);
    energy = energy / 2;
    bass_slide_ema = 0.5 * energy + 0.5 * bass_slide_ema;
    energy = bass_slide_ema;

    energy /= 4.0;
    energy /= (float) BINS_MAX;
    energy *= energy;
    // Use the "energy" of the low frequency bins to determine number of LEDs to light
    // Add 0.5 forces round to nearest integer
    //bass_slide_ema = 0.9 * energy + 0.1 * bass_slide_ema;
    int max_lit = (energy * (float)STRIP_LENGTH) + 0.5;
    int middle_led = STRIP_LENGTH / 2;

    if (millis() - bass_slide_millis > 35) {
        bass_slide_millis = millis();

        bass_slide_heights[0] = bass_slide_heights[1];
        bass_slide_heights[1] = bass_slide_heights[2];
        bass_slide_heights[2] = bass_slide_heights[3];
        bass_slide_heights[3] = bass_slide_heights[4];
        bass_slide_heights[4] = max_lit;

        /*for (int x = 0; x < NUM_BARS / 2; x++) {
            bass_slide_heights[x] = bass_slide_heights[(x+1)%(NUM_BARS/2)];
        }*/

        /*bass_slide_heights[NUM_BARS/2] = max_lit;*/
    }

    for (int x = 0; x < NUM_BARS / 2; x++) {
        int num_lit = bass_slide_heights[x];// / (float)(NUM_BARS/2 - x);
        int y = (STRIP_LENGTH / 2) - (num_lit / 2);

        for (int i = 0; i < num_lit; i++) {
            mix_pixel(x, y+i, in_factor, COLOR_TABLE[color_table_idx][0], COLOR_TABLE[color_table_idx][1], COLOR_TABLE[color_table_idx][2]);
            mix_pixel(NUM_BARS-x-1, y+i, in_factor, COLOR_TABLE[color_table_idx][0], COLOR_TABLE[color_table_idx][1], COLOR_TABLE[color_table_idx][2]);
        }

        /*for (int i = 0; i < (STRIP_LENGTH - num_lit) / 2; i++) {
            mix_pixel(x, i, in_factor, 255-COLOR_TABLE[color_table_idx][0], 255-COLOR_TABLE[color_table_idx][1], 255-COLOR_TABLE[color_table_idx][2]);
            mix_pixel(NUM_BARS-x-1, i, in_factor, 255-COLOR_TABLE[color_table_idx][0], 255-COLOR_TABLE[color_table_idx][1], 255-COLOR_TABLE[color_table_idx][2]);
            mix_pixel(x, y+i+num_lit, in_factor, 255-COLOR_TABLE[color_table_idx][0], 255-COLOR_TABLE[color_table_idx][1], 255-COLOR_TABLE[color_table_idx][2]);
            mix_pixel(NUM_BARS-x-1, y+i+num_lit, in_factor, 255-COLOR_TABLE[color_table_idx][0], 255-COLOR_TABLE[color_table_idx][1], 255-COLOR_TABLE[color_table_idx][2]);
        }*/
    }
}

/* ================================================================== *
 * Function: visualizer_classic
 * Description: Emulate Steven's original, pre-muse, visualizer.
 * Parameters: none.
 * ================================================================== */
void Bar_Matrix::visualizer_classic(audio_bins* bins, float in_factor, float out_factor) {
    decay_to_rgb(out_factor, 0, 0, 10);

    for (int i = 0; i < NUM_BINS; i++) {
        if (bd->beat_on_bin(i)) {
            fill_bar(i, 200, 200, 200);
            //fill_bar(i, COLOR_TABLE[color_table_idx][0], COLOR_TABLE[color_table_idx][1], COLOR_TABLE[color_table_idx][2]);
            color_table_idx = (color_table_idx+1) % 51;

            if (i == 6) {
                fill_bar(7, COLOR_TABLE[color_table_idx][0], COLOR_TABLE[color_table_idx][1], COLOR_TABLE[color_table_idx][2]);
                color_table_idx = (color_table_idx+1) % 51;
            }
        }
    }
}

/* ================================================================== *
 * Function: decay
 * Description: slowly fades out matrix values
 * Parameters: [float] factor - decay factor to be multiplied by
 * ================================================================== */
void Bar_Matrix::visualizer_plasma(audio_bins* bins, float in_factor, float out_factor) {
    decay(out_factor);

    for (char i = 0; i < disp_width; i++) {
        for (short j = disp_height - 1; j > 0; j-=2) {
            // Move wave up
            unsigned int color = bars[i]->getPixelColor(j-1);
            mix_pixel(i, j, in_factor, (char)(color >> 16), (char)(color >> 8), (char)(color));
            mix_pixel(i, j+1, in_factor, (char)(color >> 16), (char)(color >> 8), (char)(color));
        }

        // Set bar levels
        int level = 0;
        if (disp_width == 8) {
                switch(i) {
                    case 0:
                    level = bins->left[LEFT_160];
                    break;
                    case 1:
                    level = bins->left[LEFT_1000];
                    break;
                    case 2:
                    level = bins->left[LEFT_6250];
                    break;
                    case 3:
                    level = bins->left[LEFT_16000];
                    break;
                    case 4:
                    level = bins->right[RIGHT_16000];
                    break;
                    case 5:
                    level = bins->right[RIGHT_6250];
                    break;
                    case 6:
                    level = bins->right[RIGHT_1000];
                    break;
                    case 7:
                    level = bins->right[RIGHT_160];
                    break;
                }
            } else if (disp_width == 10) {
                switch(i) {
                    case 0:
                    level = bins->left[LEFT_63];
                    break;
                    case 1:
                    level = bins->left[LEFT_160];
                    break;
                    case 2:
                    level = bins->left[LEFT_400];
                    break;
                    case 3:
                    level = bins->left[LEFT_1000];
                    break;
                    case 4:
                    level = bins->left[LEFT_6250];
                    break;
                    case 5:
                    level = bins->right[RIGHT_6250];
                    break;
                    case 6:
                    level = bins->right[RIGHT_1000];
                    break;
                    case 7:
                    level = bins->right[RIGHT_400];
                    break;
                    case 8:
                    level = bins->right[RIGHT_160];
                    break;
                    case 9:
                    level = bins->right[RIGHT_63];
                    break;
                }  
            }

        level *= FREQ_GAIN;
        // set bar
        float val = level*2*PI/BINS_MAX;
        //float intensity = (pow((float)(level)/(float)(BINS_MAX), 2))*255;
        float intensity = (level)/(BINS_MAX)*255.0f;
        intensity *= intensity;
        if (intensity > 255) intensity = 255.0;
        mix_pixel(i, 0, in_factor, cos(val - 4*PI/3)*intensity, cos(val - 2*PI/3)*intensity, cos(val)*intensity);

        //bars[i]->setPixelColor(0, cos(val - 2*PI/3)*intensity, cos(val)*intensity, cos(val - 4*PI/3)*intensity);

    }
}

void Bar_Matrix::visualizer_pong(float in_factor) {
    pongPaddles[0].tick(&pongBall);
    pongPaddles[1].tick(&pongBall);
    pongBall.tick();

    if (bd->num_beats() != last_beat_count) {
        last_beat_count = bd->num_beats();
        if (random(0, 3) == 0 ) {
            pongPaddles[1].setColor(bd->r(), bd->g(), bd->b());
        } else if (random(0, 2) == 0) {
            pongPaddles[0].setColor(bd->r(), bd->g(), bd->b());
        } else {
            pongBall.setColor(bd->r(), bd->g(), bd->b());
        }
    }

    clear_matrix();

    // Draw paddles
    for (int i = 0; i < 2; i++) {
        for (int y = 0; y < pongPaddles[i].len; y++) {
            mix_pixel(pongPaddles[i].xPos(), pongPaddles[i].yPos()+y, in_factor, pongPaddles[i].r, pongPaddles[i].g, pongPaddles[i].b);
        }
    }

    // Draw Ball
    for (int i = 0; i < pongBall.len; i++) {
        mix_pixel(pongBall.xPos(), pongBall.yPos()+i, in_factor, pongBall.r, pongBall.g, pongBall.b);
    }
}

/* ================================================================== *
 * Function: visualizer_pulse
 * Description: Creates pulses where sound appears to be originating from
 * Parameters:  None
 * ================================================================== */
void Bar_Matrix::visualizer_pulse(audio_bins* bins, float in_factor, float out_factor, float distance_x, float distance_y) {
    decay (out_factor);

    // Calculate frequency pan and "fade"
    float pans[NUM_BINS]; // ratio left to right, 0-1
    float intensities[NUM_BINS]; // ratio low to high, 0-1
    for (char i = 0; i < NUM_BINS; i++)
    pans[i] = float(bins->left[i])/float(bins->right[i]);
    for (char i = 0; i < NUM_BINS; i++)
    intensities[i] = ((float(bins->left[i])+float(bins->right[i]))/2.0f)/BINS_MAX;

    for (char i = 0; i < disp_width; i++) {
        for (char j = 0; j < disp_height; j++) {
            float level = 0;

            // Calculate level intensity
            for (char x = 0; x < NUM_BINS; x++) {
                float distance = distance_x * 1.0f/(abs(pans[x]-(i/disp_width))) + distance_y * 1.0f/(abs((x/NUM_BINS)-(j/disp_height)));
                level += intensities[x] * distance;
            }

            //level *= 2*PI;
            //mix_pixel(i, j, in_factor, cos(level)*255*level, cos(level - 2*PI/3)*255*level, cos(level - 4*PI/3)*255*level);
            mix_pixel(i, j, in_factor, level*255, level*255, level*255);
        }
    }
}

void Bar_Matrix::visualizer_rainbow(audio_bins* bins, float in_factor, float out_factor) {
    decay(out_factor);

    for (char i = 0; i < disp_width/2; i++) {
        int led_index = 0;
        for (char j = 0; j < STRIP_LENGTH; j+=10) {
            // get bin
            int level = bins->left[j/10];
            level *= FREQ_GAIN;
            // set bar
            if (i < (pow((float)(level)/(float)(BINS_MAX), 2)) * (disp_width/2)) {
                float val = level*PI/BINS_MAX;
                for (int x = 0; x < 10; x++) {
                    //mix_pixel((disp_width/2)-i-1, x*NUM_BARS+led_index, in_factor, cos(val)*255, cos(val - 2*PI/3)*255, cos(val - 4*PI/3)*255);
                    mix_pixel((disp_width/2)-i-1, x*NUM_BARS+led_index, in_factor, bd->r(), bd->g(), bd->b());
                }
            }

            led_index++;
            led_index = led_index%10;
        }
    }

    for (char i = disp_width/2; i < disp_width; i++) {
        int led_index = 0;
        for (char j = 0; j < STRIP_LENGTH; j+=10) {
            // get bin
            int level = bins->right[j/10];
            level *= FREQ_GAIN;
            // set bar
            if (i-disp_width/2 < (pow((float)(level)/(float)(BINS_MAX), 2)) * (disp_width/2)) {
                float val = level*PI/BINS_MAX;
                for (int x = 0; x < 10; x++) {
                    //mix_pixel(i, x*NUM_BARS+led_index, in_factor, cos(val)*255, cos(val - 2*PI/3)*255, cos(val - 4*PI/3)*255);
                    mix_pixel(i, x*NUM_BARS+led_index, in_factor, bd->r(), bd->g(), bd->b());
                }
            }

            led_index++;
            led_index = led_index%10;
        }
    }

    for (char i = 0; i < disp_width; i++) {
        for (char j = 0; j < STRIP_LENGTH/4; j++) {
            // get bin
            int level = 0;//bins->left[i%(NUM_BARS-1)];
            if (disp_width == 8) {
                switch(i) {
                    case 0:
                    level = bins->left[LEFT_160];
                    break;
                    case 1:
                    level = bins->left[LEFT_1000];
                    break;
                    case 2:
                    level = bins->left[LEFT_6250];
                    break;
                    case 3:
                    level = bins->left[LEFT_16000];
                    break;
                    case 4:
                    level = bins->right[RIGHT_16000];
                    break;
                    case 5:
                    level = bins->right[RIGHT_6250];
                    break;
                    case 6:
                    level = bins->right[RIGHT_1000];
                    break;
                    case 7:
                    level = bins->right[RIGHT_160];
                    break;
                }
            } else if (disp_width == 10) {
                switch(i) {
                    case 0:
                    level = bins->left[LEFT_63];
                    break;
                    case 1:
                    level = bins->left[LEFT_160];
                    break;
                    case 2:
                    level = bins->left[LEFT_400];
                    break;
                    case 3:
                    level = bins->left[LEFT_1000];
                    break;
                    case 4:
                    level = bins->left[LEFT_6250];
                    break;
                    case 5:
                    level = bins->right[RIGHT_6250];
                    break;
                    case 6:
                    level = bins->right[RIGHT_1000];
                    break;
                    case 7:
                    level = bins->right[RIGHT_400];
                    break;
                    case 8:
                    level = bins->right[RIGHT_160];
                    break;
                    case 9:
                    level = bins->right[RIGHT_63];
                    break;
                }  
            }
            level *= FREQ_GAIN;

            // set bar
            if (j < (pow((float)(level)/(float)(BINS_MAX), 2)) * (STRIP_LENGTH/2)) {
                float val = level*2*PI/BINS_MAX;
                mix_pixel(i, STRIP_LENGTH/2 - j, .95, 255-bd->r(), 255-bd->g(), 255-bd->b());
            }
        }

        // Left bins, grow upwards
        for (char j = STRIP_LENGTH/2; j < STRIP_LENGTH*0.75f; j++) {
            // get bin
            int level = 0;
            if (disp_width == 8) {
                switch(i) {
                    case 0:
                    level = bins->left[LEFT_160];
                    break;
                    case 1:
                    level = bins->left[LEFT_1000];
                    break;
                    case 2:
                    level = bins->left[LEFT_6250];
                    break;
                    case 3:
                    level = bins->left[LEFT_16000];
                    break;
                    case 4:
                    level = bins->right[RIGHT_16000];
                    break;
                    case 5:
                    level = bins->right[RIGHT_6250];
                    break;
                    case 6:
                    level = bins->right[RIGHT_1000];
                    break;
                    case 7:
                    level = bins->right[RIGHT_160];
                    break;
                }
            } else if (disp_width == 10) {
                switch(i) {
                    case 0:
                    level = bins->left[LEFT_63];
                    break;
                    case 1:
                    level = bins->left[LEFT_160];
                    break;
                    case 2:
                    level = bins->left[LEFT_400];
                    break;
                    case 3:
                    level = bins->left[LEFT_1000];
                    break;
                    case 4:
                    level = bins->left[LEFT_6250];
                    break;
                    case 5:
                    level = bins->right[RIGHT_6250];
                    break;
                    case 6:
                    level = bins->right[RIGHT_1000];
                    break;
                    case 7:
                    level = bins->right[RIGHT_400];
                    break;
                    case 8:
                    level = bins->right[RIGHT_160];
                    break;
                    case 9:
                    level = bins->right[RIGHT_63];
                    break;
                }  
            }
            level *= FREQ_GAIN;
            // set bar
            float p = (float)(level)/(float)(BINS_MAX);
            if (j-STRIP_LENGTH/2 < (pow((float)(level)/(float)(BINS_MAX), 2)) * (STRIP_LENGTH/2)) {
                //j-STRIP_LENGTH/2 < (pow((float)(level)/(float)(BINS_MAX), 2)) * (STRIP_LENGTH/2)) {
                float val = level*2*PI/BINS_MAX;
                //mix_pixel(i, j, in_factor, cos(val)*255, cos(val - 2*PI/3)*255, cos(val - 4*PI/3)*255);
                mix_pixel(i, j, .95, 255-bd->r(), 255-bd->g(), 255-bd->b());//reds[i], greens[i], blues[i]);
            }
        }
    }
}

/* ================================================================== *
 * Function: snake_lines
 * Description: Snake runs up and down each bar
 * Parameters: [float] speed - speed snake moves at
 * ================================================================== */
void Bar_Matrix::snake_lines(float speed) {
    bool noChange = true;

    fill_matrix(Color_Value(0, 0, 0));

    for (int x = 0; x < NUM_SNAKES; x++) {
        Snake *s = &snakes[x];

        for (int i = 0; i < s->len; i++) {
            int b = (s->pos + i) / STRIP_LENGTH; // bar
            int p = (s->pos + i) % STRIP_LENGTH; // pixel

            if (b % 2 == 1) {
                p = 69-p;
            }

            mix_pixel(b, p, .95, s->r, s->g, s->b);
        }

        if (noChange && random(0, 10) > 7) {
            s->r = bd->r();
            s->g = bd->g();
            s->b = bd->b();
            noChange = false;
        }

        s->posTicks++;
        if (s->posTicks >= s->ticksNeeded) {
            s->posTicks = 0;
            s->pos += s->dir;
        }
        if ((s->dir > 0 && s->pos > NUM_BARS * STRIP_LENGTH +s->len) ||
            (s->dir < 0 && s->pos < -s->len))
        {
            color_table_idx += random(0, 10);
            color_table_idx = color_table_idx % 50;

            s->pos = s->dir > 0 ? -s->len : NUM_BARS * STRIP_LENGTH;
        }
    }
}

/* ================================================================== *
 * Function: visualizer_wheel
 * Description: Sets all bars to a color while rotating through all
 *              hues in order of the rainbow
 * Parameters: [float] intensity - intensity of lights
 *             [float] speed - speed wheel rotates at
 * ================================================================== */
void Bar_Matrix::visualizer_wheel(float intensity, float speed) {
    float val = fmod(millis()/10000.0f,1.0f)*2.0f*PI;
    fill_matrix(Color_Value(cos(val)*255*intensity, cos(val - 2*PI/3)*255*intensity, cos(val - 4*PI/3)*255*intensity));
}
