jason-merlo/muse/(commit log)

2015-09-15 Initial commit
    Adding sample_freq function
2015-09-20 Added logic for leds from audio binning
    Testing only
2015-09-20 Working software prototype, starting PCB modeling
2015-09-20 Created KiCad schematic v1 (missing pwr_sw)
    Re-allocated pins
    [muse.kicad_pcb, muse.sch]
2015-09-20 Added Power Switch (v1 complete)
    [muse.sch]
2015-09-22 Updated power distibution
    Removed onboard power routing to allow for high current wire to be
    added directly to terminal block.
    [muse.sch]
2015-09-22 Created custom footprints and added to PCB
    Setting up PCB
    [_saved_muse.sch, muse.kicad_pcb]
2015-09-22 Preliminary PCB Layout in progress
    [_saved_muse.sch, muse.kicad_pcb, muse.sch]
2015-09-22 Preliminary board layout complete
    TODO: Route circuitry
    [muse.kicad_pcb, muse.sch]
2015-09-23 Preliminary circuit made (sans gnd plane)
    [muse.kicad_pcb]
2015-09-23 Completed muse v1.0 board
    [muse-B_Cu.gbr, muse-B_Mask.gbr, muse-B_SilkS.gbr, muse-Edge_Cuts.gbr, muse-F_Cu.gbr, muse-F_Mask.gbr, muse-F_SilkS.gbr, muse.drl]
2015-09-26 Updated test source code, final PCB layout
    [muse.GBL, muse.GBO, muse.GBS, muse.GKO, muse.GTL, muse.GTO, muse.GTS, muse.XLN]
2015-11-05 Implemented color wheel mode
2015-11-13 Basic bars visualizer with right channel workaround
    [bar_matrix.cpp, bar_matrix.h, muse.cpp, muse.h]
2015-11-17 Fixed decay, added decay factor
    [bar_matrix.cpp, bar_matrix.h, muse.cpp]
2015-11-17 Change delay(1) to delayMicroseconds(40)
    The MSGEQ7 needs 36uS not a whole millisecond
2015-11-18 Added fading per-pixel in and out on bar visualizer
    Additionally, removed wheel function
2015-12-19 Started V2
    [muse-B_Cu.gbr, muse-B_Mask.gbr, muse-B_SilkS.gbr, muse-Edge_Cuts.gbr, muse-F_Cu.gbr, muse-F_Mask.gbr, muse-F_SilkS.gbr, muse.GBL]
2015-12-19 Finished updates schematic, removed gerber files
    [muse-B_Cu.gbr, muse-B_Mask.gbr, muse-B_SilkS.gbr, muse-Edge_Cuts.gbr, muse-F_Cu.gbr, muse-F_Mask.gbr, muse-F_SilkS.gbr, muse.GBL]
2015-12-21 Rev 2.0 Complete
    [muse.kicad_pcb, muse.sch]
2015-12-21 Added more ground paths to v2
    [muse.kicad_pcb]
2015-12-21 Gerbers generated and sent to Oshpark
    [muse.GBL, muse.GBO, muse.GBS, muse.GKO, muse.GTL, muse.GTO, muse.GTS, muse.XLN]
2015-12-21 Changed versioning scheme. Fixed problems and reuploaded to oshpark
    [muse-B_Cu.gbr, muse-B_Mask.gbr, muse-B_SilkS.gbr, muse-Edge_Cuts.gbr, muse-F_Cu.gbr, muse-F_Mask.gbr, muse-F_SilkS.gbr, muse.GBL]
2016-01-11 Fixes for PCB revision 1.1
    PSU power is controlled by the core. PSU is on whenever the core is on
    by default.
    [muse.cpp, muse.h]
2016-01-12 Added code for bouncing lines "screen saver"
    Lines between 1 LED and half the strip of LEDs will bounce up and down.
2016-01-13 Added a sleep/psu auto off function. Still buggy
    Weird bug slows down everything once the music stops
    [muse.cpp, muse.h]
2016-01-13 Fixed up screensaver/auto shutoff
    Using Time.now() as it is way more accurate than millis().
    Millis() looses track of time when interrupts are turned off for a long
    period of time as they are in the neopixel library. Time.now seems much
    more accurate.
    [muse.cpp, muse.h]
2016-01-13 Clear_matrix and show_all before psu change
    Prevents flashing on startup/shutdown
    [muse.cpp]
2016-01-14 Created V1.2 Project, Completed marked "issues" in schematic
    PCB still needs to be updated
    [muse.GBL, muse.GBO, muse.GBS, muse.GKO, muse.GTL, muse.GTO, muse.GTS, muse.XLN]
2016-01-14 Cleaning up code, screensaver & power in progress
2016-01-14 Added switch for visualizers, cleaned up bouncing lines
2016-01-15 Fixed channels and updated visualizer setups for more customization
    [bar_matrix.cpp, bar_matrix.h, muse.cpp, muse.h]
2016-01-17 Added strobe mode, still buggy
    [bar_matrix.cpp, bar_matrix.h, muse.cpp]
2016-01-18 Fixed missing call to init_eq on startup
    [muse.cpp, muse.h]
2016-01-19 Fixed ENABLE_AUTO_SHUTDOWN flag, indenting
    [muse.cpp, muse.h]
2016-01-19 Currently serving small static webpage
2016-02-06 Added 8th bar average and sharper cut off for color rather than a fade out.
2016-04-05 Switch back to BARS_MIDDLE
2016-04-08 Add 1ms delay to main loop
    Corrects issues with flashing new code from the cloud taking many attemps to succeed.
    [muse.cpp]
2016-04-08 Update bar_matrix to use beat_detection class.
    Removed all beat detection that was implemented in bar_matrix and replaced it with calls to the new Beat_Detection_class.
    [bar_matrix.cpp]
2016-04-08 Fixed indentation on function headers
    [bar_matrix.cpp, bar_matrix.h, muse.cpp]
2016-04-09 Group and reorder/alphabetize functions
    All the functions in here were mixed together kinda randomly. Made a few functions private since they didn't need to be called from outside this class. Alphabetize functions within their subgroups (public/private > visualizer or general > alpha order)
    [bar_matrix.cpp, bar_matrix.h]
2016-04-10 Add back in call to sample_freq. Accidentally removed during merging.
2016-04-21 Switch to Jason\'s multicolored bars
2016-05-03 Initial Webduino 'port'. Currently serving up a Hello World page via HTTP.
    Will clean up new classes and create better defineguards in next few commits.
2016-05-04 Webserver with working radio buttons to select visualizer.
    Connect to the server's IP and click a radio button to choose a visualizer.
2016-05-05 More options added to web control panel.
    Also added some code to use mDNS, that's not working + commented out.
    [server.cpp, server.h]
2016-05-05 Fixed minor bug in handling other bar displays
    [server.cpp]
2016-05-16 Begin adding webpage controlled power.
    Still need to implement checking function in server.cpp... Need to change callback signitures for the webserver first.
2016-05-16 Working callbacks/power on and off buttons. Disabled AUTO_SHUTDOWN of PSU.
    Callbacks from the WebServer library now include a pointer to a given object (usually server.cpp instance). There is also a power button on the webpage now.
    Disabled Auto Shutdown of PSU in order to use the webpage on/off buttons. Best solution I have for now. It could probably be fixed to work with both in the future fairly easily.
    [WebServer.cpp, WebServer.h, muse.cpp, server.cpp, server.h]
2016-05-20 Added interval timer to web server ticks to reduce light latency
2016-05-20 Trying my damnedest to fix stupid :)
    [bar_matrix.cpp, bar_matrix.h, muse.cpp, muse.h, server.cpp]
2016-05-21 Highlight buttons on hover
2016-05-21 Change switches that validate input.
2016-05-25 Add update interval for display.
    Current visualizer, bin sampling, and beat detection now run every DISPLAY_UPDATE_INTERVAL millis instead of each time the main loop is run. Helps a bit with server/mdns responsiveness. Also increased server/mdns update rate.
    Added misc trackers to display on cloud variables.
2016-06-15 Working communication between Pi and Photon
    No longer attempting SPI. Using one wire for data, one as a 'data received' by the Photon and one as a 'data ready' from the Pi. The Pi puts data on the data line, toggles the value of the data ready line. When the Photon sees this line toggle it reads the data and toggles its data received line. The two go back and forth until all 8 bits are sent.
    [muse.cpp]
2016-07-23 Update pi server to handle power on/off and all visualizers
2016-07-31 Separate beat detection from bar matrix
    This change allows for beat detection even when not drawing any new frames. The beat detection instance is stored in muse and is passed by reference to the bar matrix instance. Muse's tick function is now responsible for calling beat detection's tick.
2016-08-01 Update beat detection moving average lengths and add a periodic reset to pi server communication
    [beat_detection.h]
2016-08-10 Correct BIN_MAX from 4096 to 4095
    [muse.h]
2016-08-12 Cleanup, adjust include guards, powered_on_tick method to control sampling/frame updates
    Variables/rountines should now be properly disabled based on the ENABLE_X values in muse.h. Created a powered_on_tick() method to run sampling/beat detection/frame updates. Updated the main loop to make use of powered_on_tick instead of having 3 copies of the same code.
2016-08-12 Move commonly changed settings to settings.h
    Per user/per hardware instance settings will no longer be committed. Should keep us from messing with each other's settings.
    [muse.h]
2016-08-12 Add define guard to some psu control in powered_on_tick
2016-09-25 Bugfix on snake and change a snakes length
    [bar_matrix.cpp]
2016-10-15 Fix some define guards
    [muse.cpp, settings_template.h]
2016-11-05 Added tcp beat detection cabinet changing. Some weird crash happens though
    [bar_matrix.cpp, bar_matrix.h]
2016-11-06 Convert from wired communication to UDP communication
2017-01-11 Add bass slide visualizer and fix IP address
    [bar_matrix.cpp, bar_matrix.h, muse.h]
2017-03-02 Replace 4096.0s with BINS_MAX and change color of ambient light
    [bar_matrix.cpp]
2017-03-05 Fix pong paddle bouncing
    [pong_paddle.cpp]
2017-04-15 Speed up decay on bars visualizer, reorder bars, print IP address
2021-03-27 Added rev 1.3
    [muse-2021-02-01-08-25-26.sch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]
2021-05-29 Muse v1.3
    [muse.kicad_pcb, muse.sch]
